jeffersonpimenta/Carga_Eletronica/Readme.md

Projeto de uma carga eletrônica inteligente (electronic load) apresentado como trabalho de fim de curso pela Universidade Federal do Ceará.
