jeffersonpimenta/Carga_Eletronica/TCC_UFC/Desenvolvimento de um emulador dinâmico de carga.pdf

# Desenvolvimento de um emulador dinâmico de carga

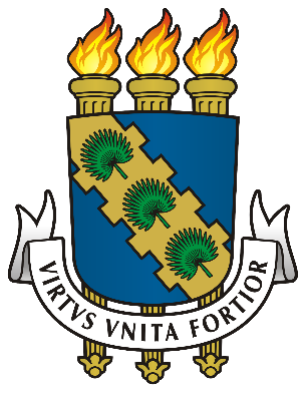
[picture p37: figure]

# JÉFFERSON PIMENTA MELO UNIVERSIDADE FEDERAL DO CEARÁ

# CAMPUS DE SOBRAL

# Emulador dinâmico de carga

# Equipamento eletrônico, de bancada

# Se comporta como uma carga passiva em termos de corrente e potência drenada do equipamento sob ensaio

# Regenerativo e/ou dissipativo

# Configurável em uma gama de valores

# Entrada de corrente CC e/ou CA

# Emula cargas lineares e/ou não lineares

# Emula cargas dinâmicas e estáticas (sazonalidade)

Conceitos básicos

Utilidades

Objetivos

Desenvolvimento

Resultados

Conclusões

Melhorias Futuras

# Fluxo de potência

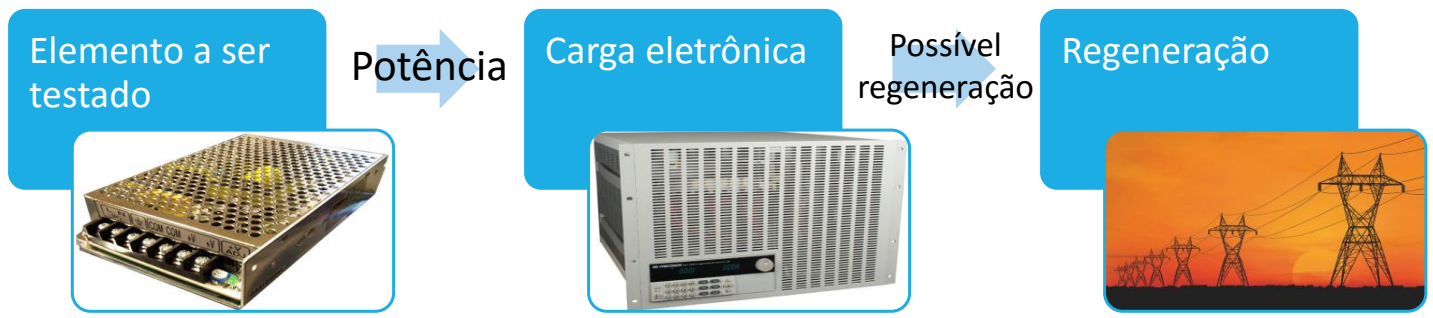
[picture p38: figure]
Elemento a ser testado; regeneração

Carga eletrônica | Regeneração Potência | Possível

Conceitos básicos

Utilidades

Objetivos

Desenvolvimento

Resultados

Conclusões

Melhorias Futuras

# Modo de operação

# Corrente constante

# Resistência constante

# Potência constante

Conceitos básicos

Utilidades

Objetivos

Desenvolvimento

Resultados

Conclusões

Melhorias Futuras

# Modo de operação

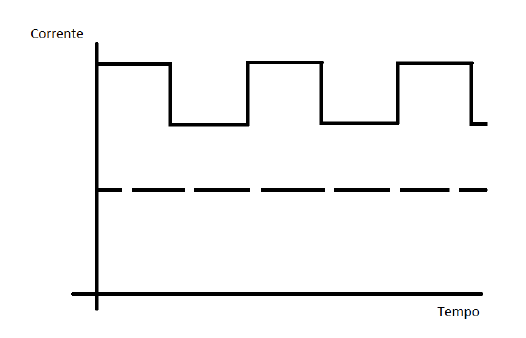
[picture p39: figure]

# Sazonalidade da carga emulada

Conceitos básicos

Utilidades

Objetivos

Desenvolvimento

Resultados

Conclusões

Melhorias Futuras

# Utilidades

Substituem os bancos de resistores, banco de capacitores e banco de indutores em testes de diversos

# equipamentos

- Fontes ininterruptas de energia - Inversores - Gradadores - Fontes de tensão - Fontes de corrente - Chaves eletrônicas ou eletromecânicas - Circuitos de proteção - Fusíveis - Disjuntores - Conectores - Linhas de transmissão - Transformadores - Geradores - Medidores de energia - Conversores chaveados

Conceitos básicos

Utilidades

Objetivos

Desenvolvimento

Resultados

Conclusões

Melhorias Futuras

# Objetivos

# Estudo do funcionamento dos equipamentos disponíveis no mercado

# Desenvolvimento e construção de um equipamento capaz de ensaiar conversores

# - Trabalho em regime de corrente CC - Equipamento deve ser preciso - Interface amigável - Baixo custo - Alta reprodutibilidade

Conceitos básicos

Utilidades

Objetivos

Desenvolvimento

Resultados

Conclusões

Melhorias Futuras

# Desenvolvimento

# Equipamento inspirado no projeto do engenheiro Sueco Lukas Rosén e Sahar Samimi

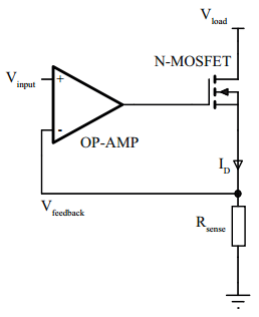
[picture p40: figure]

# Circuito base Fonte: Rosén; Samimi, 2012


# Circuito executado Fonte: autor

Conceitos básicos

Utilidades

Objetivos

Desenvolvimento

Resultados

Conclusões

Melhorias Futuras

# Proteções adotadas


Conceitos básicos

Utilidades

Objetivos

Desenvolvimento

Resultados

Conclusões

Melhorias Futuras

# Medição de corrente


Conceitos básicos

Utilidades

Objetivos

Desenvolvimento

Resultados

Conclusões

Melhorias Futuras

# Medição de tensão

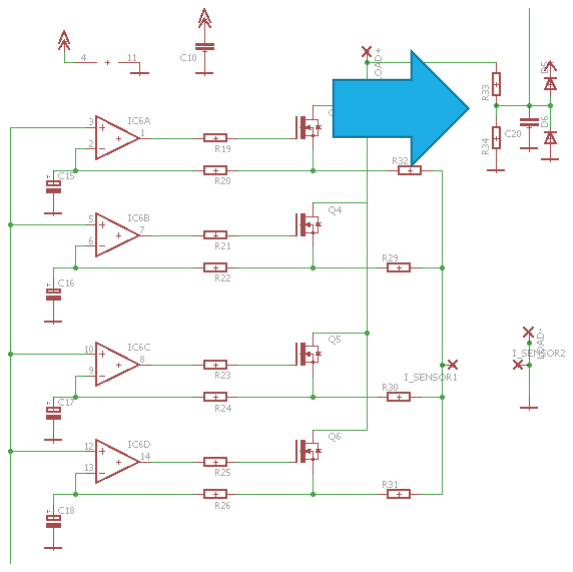
[picture p41: figure]

Conceitos básicos

Utilidades

Objetivos

Desenvolvimento

Resultados

Conclusões

Melhorias Futuras

# Placa de circuito impresso

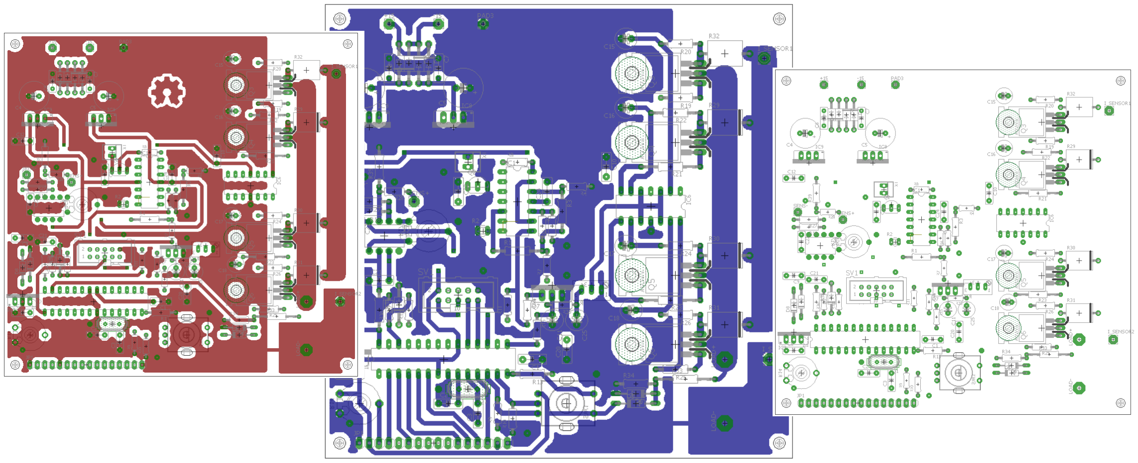
[picture p42: figure]

Conceitos básicos

Utilidades

Objetivos

Desenvolvimento

Resultados

Conclusões

Melhorias Futuras

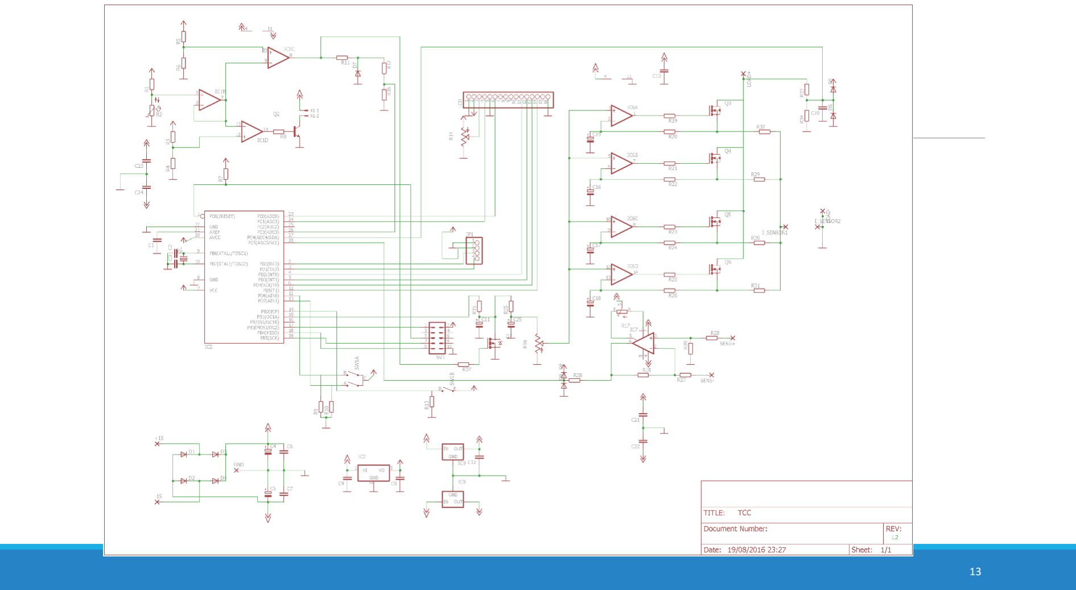
[picture p43: page 13]

# Montagem final

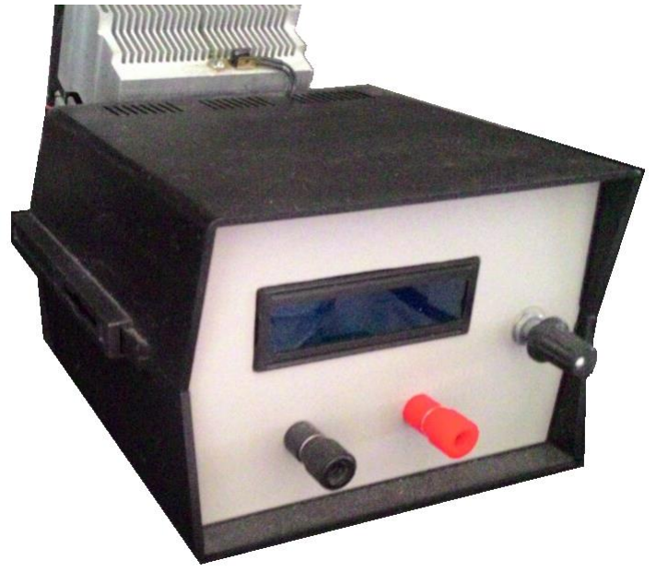
[picture p44: figure]

Conceitos básicos

Utilidades

Objetivos

Desenvolvimento

Resultados

Conclusões

Melhorias Futuras

# Interface

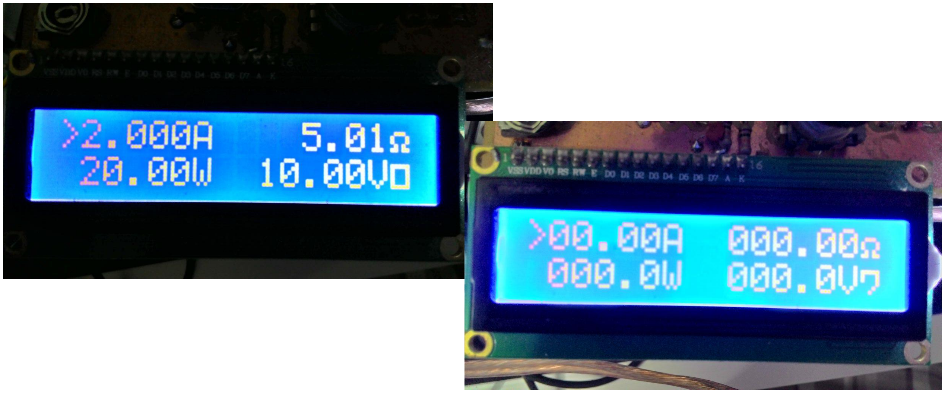
[picture p45: figure]

Conceitos básicos

Utilidades

Objetivos

Desenvolvimento

Resultados

Conclusões

Melhorias Futuras

# PCI

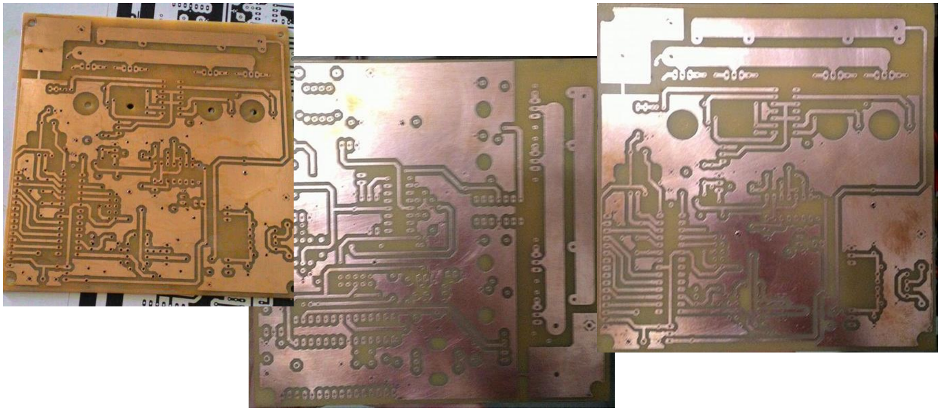
[picture p46: figure]

Conceitos básicos

Utilidades

Objetivos

Desenvolvimento

Resultados

Conclusões

Melhorias Futuras

# Conclusões

# Funcionamento estável

# Pequeno erro no desenho da PCI

# Necessidade de um software para exportar os dados para o computador, bem como seu controle

# Construção fácil, flexível e com componentes comuns no mercado

# Sobreviveu ao “teste de fogo” com os alunos de eletrônica de potência

Conceitos básicos

Utilidades

Objetivos

Desenvolvimento

Resultados

Conclusões

Melhorias Futuras

# Melhorias futuras

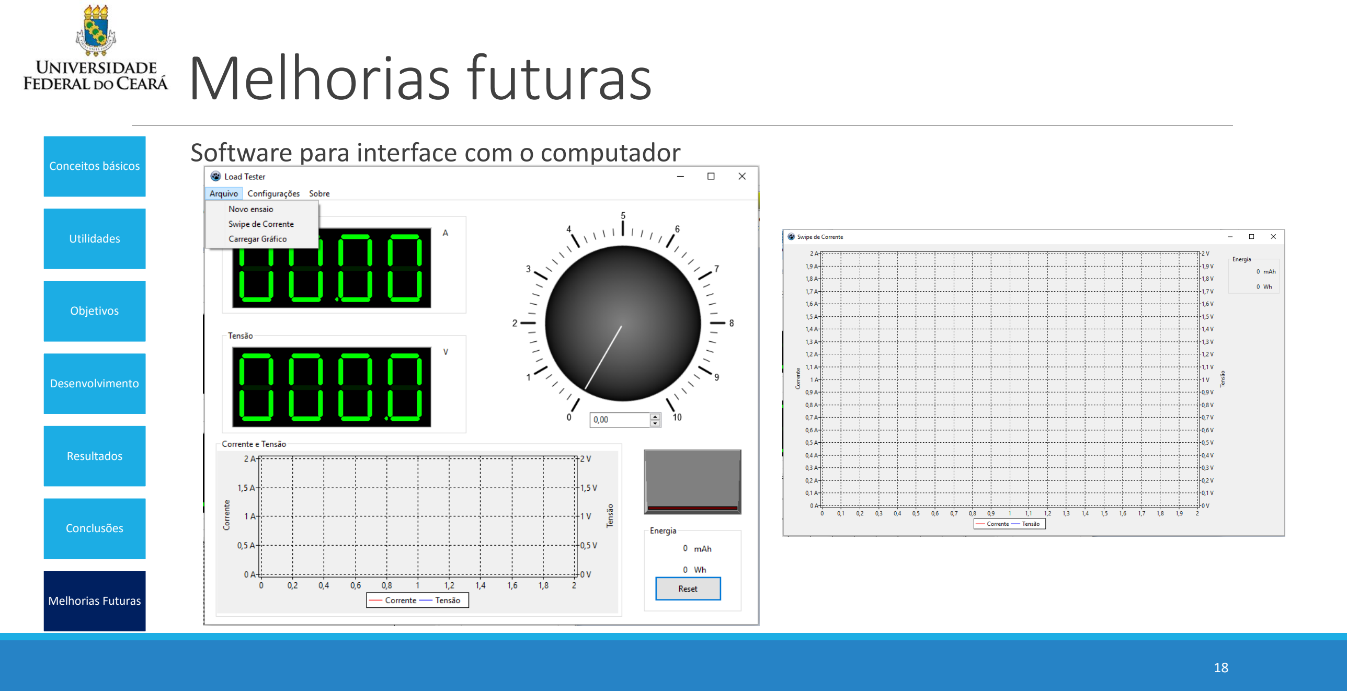
[picture p47: page 18]

# Software para interface com o computador

Conceitos básicos

Utilidades

Objetivos

Desenvolvimento

Resultados

Conclusões

Melhorias Futuras

# Melhorias futuras

# Proteção contra sobretensão na entrada do equipamento

# Utilização de sensores de corrente mais precisos

# Utilização de ADC externos ao microcontrolador para leitura de corrente e tensão

# Utilização de um processador mais poderoso

# Melhorar a malha de controle de corrente

# Dissipadores maiores

# Software para interface com o computador

Conceitos básicos

Utilidades

Objetivos

Desenvolvimento

Resultados

Conclusões

Melhorias Futuras

# JEFFERSON.PIMENTA@HOTMAIL.COM
