jeffersonpimenta/Carga_Eletronica/Fotos/board1.png

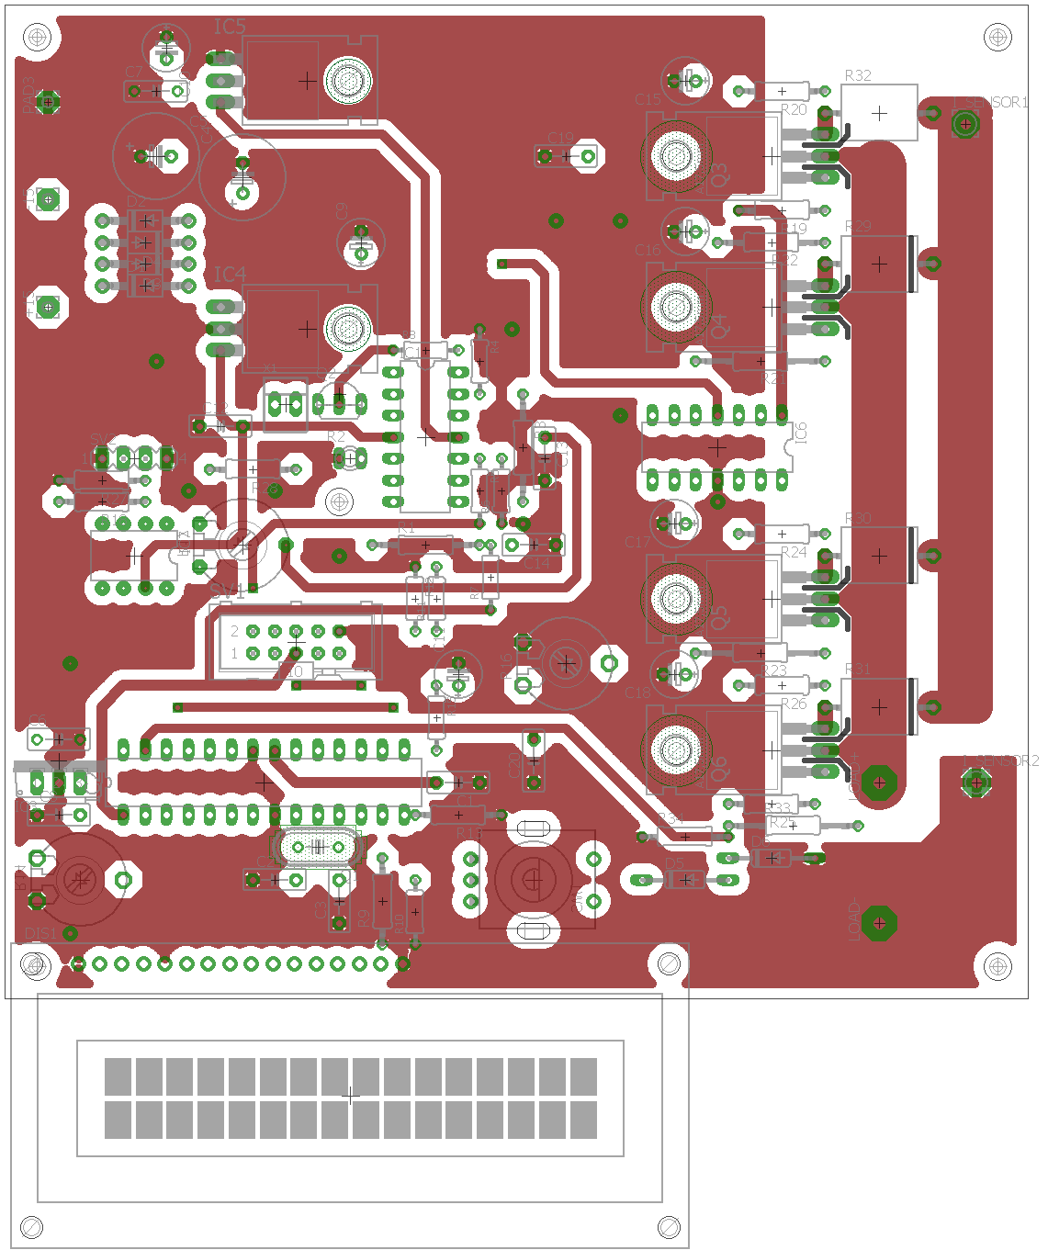
Fotos/board1.png
