jeffersonpimenta/Carga_Eletronica/Fotos/board2.png

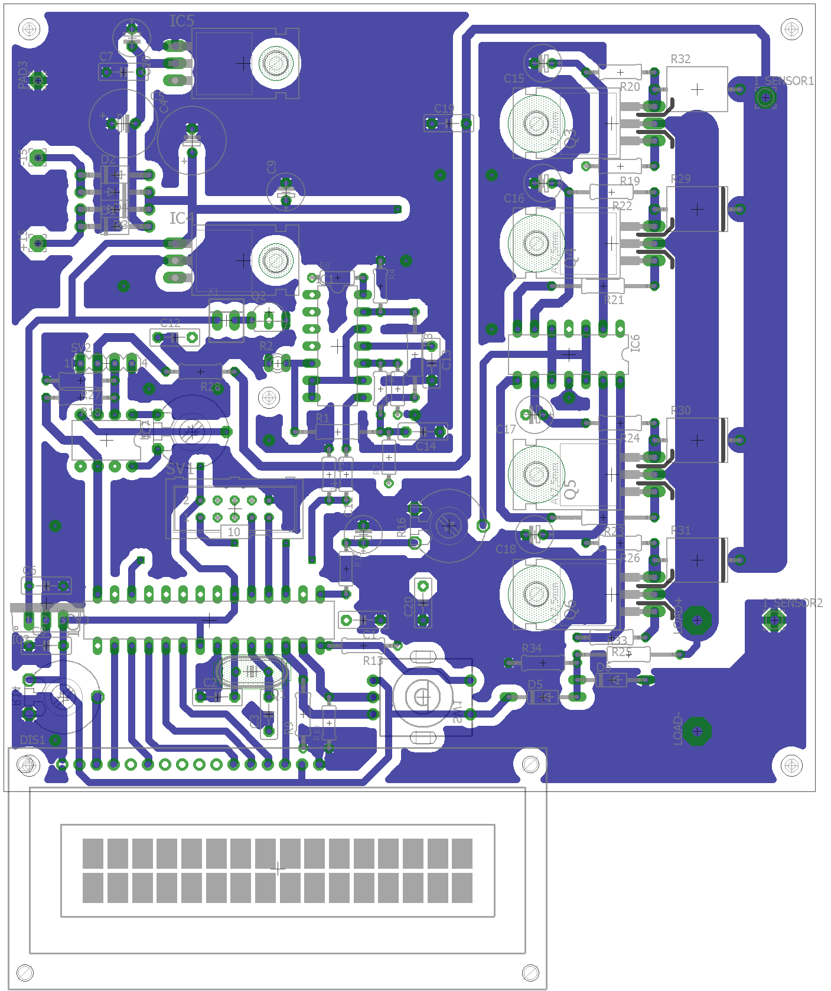
Fotos/board2.png
