jeffersonpimenta/Carga_Eletronica/Fotos/Software1.png

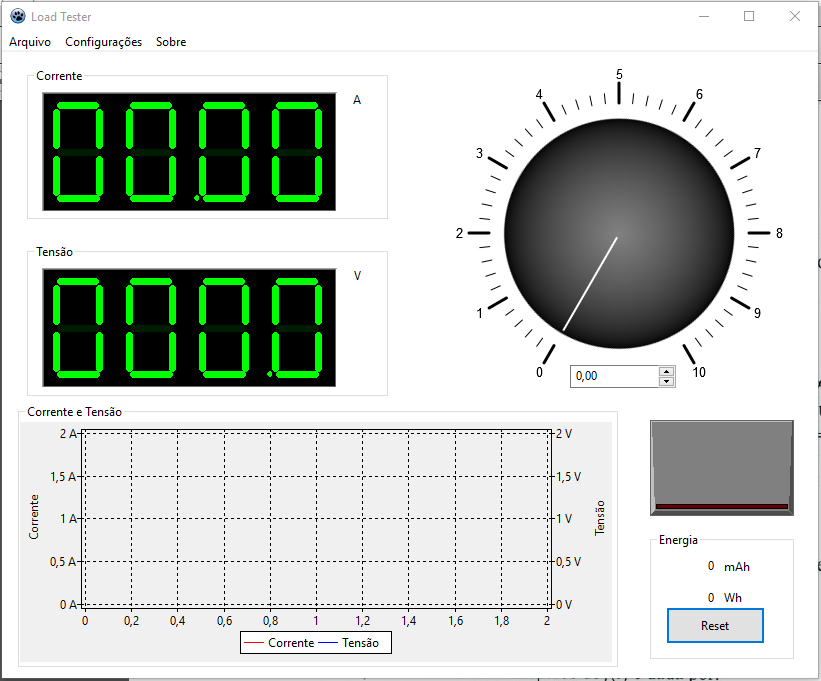
Fotos/Software1.png
