jeffersonpimenta/Carga_Eletronica/Fotos/Software3.png

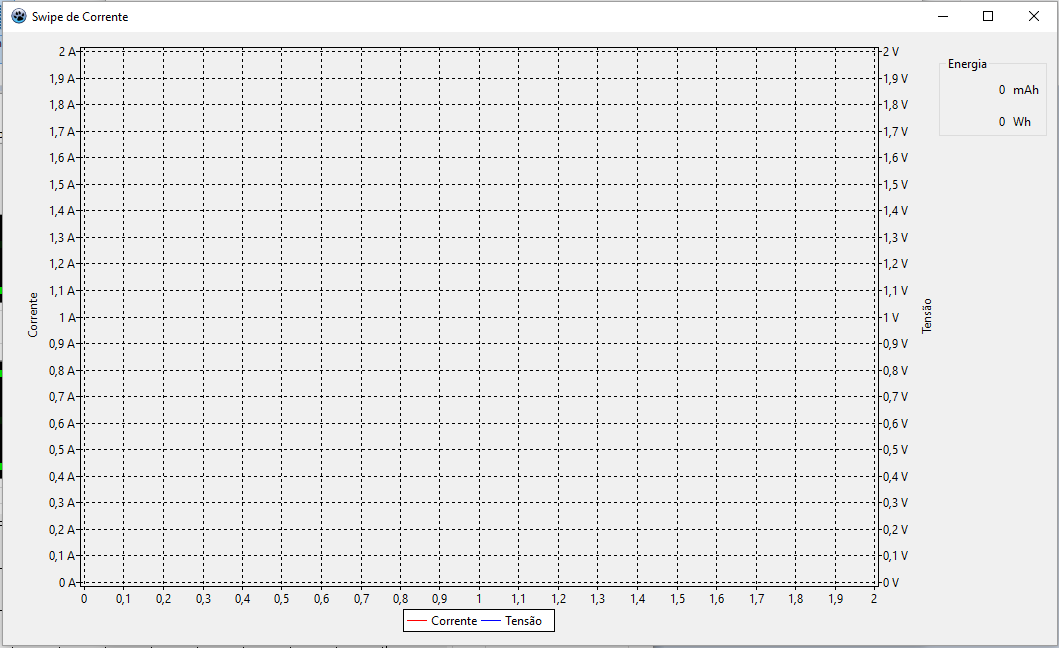
Fotos/Software3.png
