jeffersonpimenta/Carga_Eletronica/Fotos/TCC.png

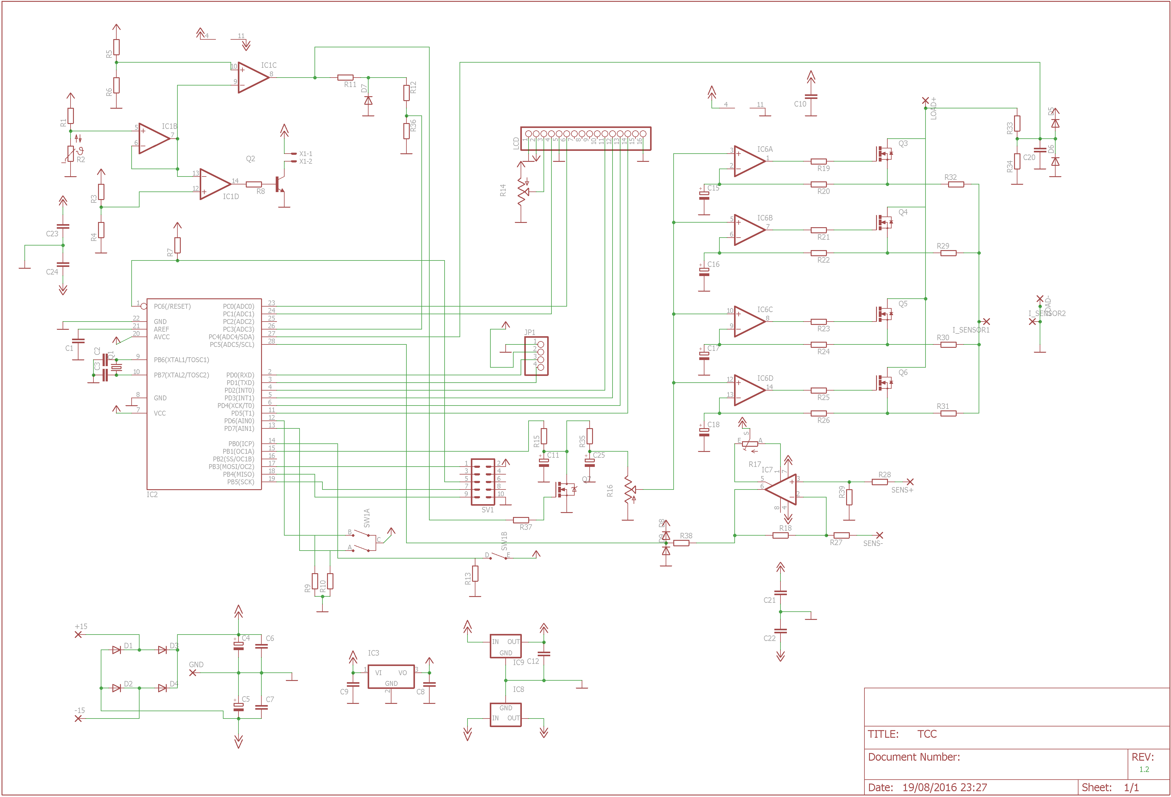
Fotos/TCC.png
