jeffersonpimenta/Carga_Eletronica/Placa/TCC.brd

## EAGLE design Placa/TCC.brd (2017-04-07)

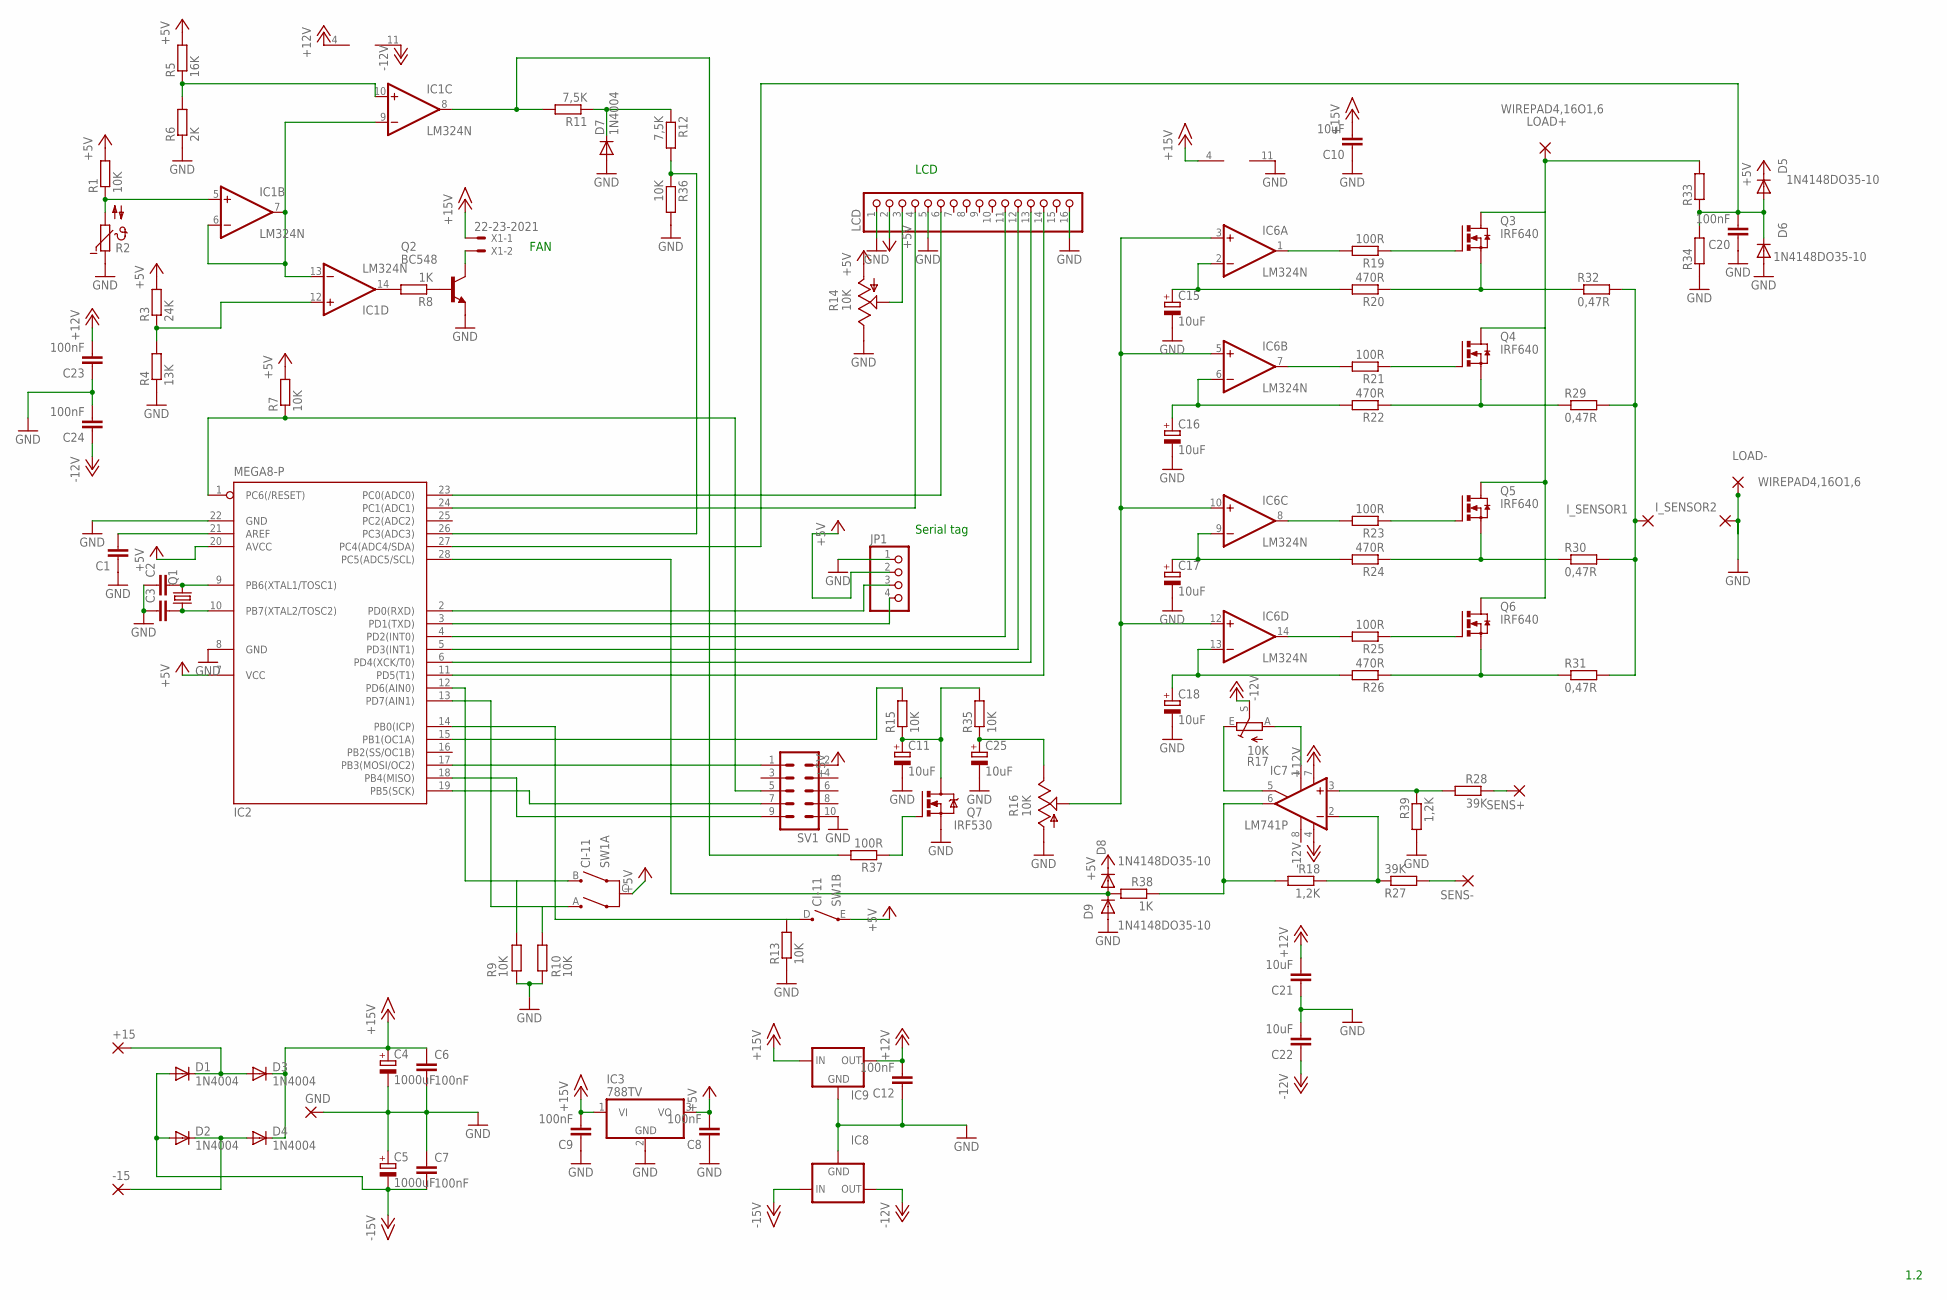
[picture p53: schematic TCC.sch]

Parts:
+15: 2,54/0,9
-15: 2,54/0,9
C1, C2, C3: C5/2.5; C5B2.5
C4, C5: 1000uF; E3,5-10
C6, C7: 100nF; C050-025X075
C8, C9, C12, C20, C23, C24: 100nF; C5B2.5
C10, C21, C22: 10uF; C5B2.5
C11, C15, C16, C17, C18, C25: 10uF; E2,5-6E
D1, D2, D3, D4, D7: 1N4004; DO41-10
D5, D6, D8, D9: 1N4148DO35-10; DO35-10
GND: 2,54/0,9
IC1, IC6: LM324N; DIL14
IC2: MEGA8-P; DIL28-3
IC3: 788TV; TO220V
IC7: LM741P; DIL08
IC8: 79XXS
IC9: 78XXS
I_SENSOR1, I_SENSOR2: 3,17/1,3
JP1: PINHD-1X4; 1X04
LCD: PINHD-1X16; 1X16
LOAD+: WIREPAD4,16O1,6; 4,16O1,6
LOAD-: WIREPAD4,16O1,6; 4,16O1,6
Q1: CRYSTALHC49S; HC49/S
Q2: BC548; TO92-EBC
Q3, Q4, Q5, Q6: IRF640; TO220BH
Q7: IRF530; TO220BV
R1: 10K; 0207/12
R2: NTC640; P640
R3: 24K; 0207/10
R4: 13K; 0204/7
R5: 16K; 0204/7
R6: 2K; 0204/7
R7, R9, R10, R15, R35, R36: 10K; 0204/7
R8: 1K; 0204/7
R11, R12: 7,5K; 0204/7
R13: 10K; 0207/10
R14: 10K; LI10@1
R16: 10K; S64W
R17: 10K; LI10
R18, R39: 1,2K; 0207/10
R19, R25: 100R; 0207/10
R20, R24, R26: 470R; 0207/10
R21, R23: 100R; 0207/15
R22: 470R; 0207/12
R27: 39K; 0207/10
R28: 39K; 0204/7
R29, R30, R31, R32: 0,47R; VTA56
R33: R-EU_0207/15; 0207/15
R34: R-EU_0207/10; 0207/10
R37: 100R; 0204/7
R38: 1K; 0207/10
SENS+: 2,54/1,1
SENS-: 2,54/1,1
SV1: ML10
SW1: CI-11
X1: 22-23-2021

Connections:
+5V: C8.2, D5.C, D8.C, IC2.7 (VCC), IC2.20 (AVCC), IC3.3 (VO), JP1.2, LCD.2, R1.2, R3.2, R5.2, R7.2, R14.A, SV1.2, SW1.C, SW1.E
+12V: C12.2, C21.2, C23.2, IC1.4 (V+), IC7.7 (V+), IC9.OUT
+15V: C4.+, C6.1, C9.2, C10.2, D3.C, D4.C, IC3.1 (VI), IC6.4 (V+), IC9.IN, X1.1
-12V: C22.1, C24.1, IC1.11 (V-), IC7.4 (V-), IC8.OUT, R17.S
-15V: C5.-, C7.2, D1.A, D2.A, IC8.IN
GND: C1.1, C2.1, C3.1, C4.-, C5.+, C6.2, C7.1, C8.1, C9.1, C10.1, C11.-, C12.1, C15.-, C16.-, C17.-, C18.-, C20.1, C21.1, C22.2, C23.1, C24.2, C25.-, D6.A, D7.A, D9.A, GND.1, IC2.8 (GND), IC2.22 (GND), IC3.2 (GND), IC6.11 (V-), IC8.GND, IC9.GND, I_SENSOR2.1, JP1.1, LCD.1, LCD.5, LCD.16, LOAD-.1, Q2.E, Q7.S, R2.1, R4.1, R6.1, R9.1, R10.1, R13.1, R14.E, R16.A, R34.1, R36.2, R39.2, SV1.10
unnamed: C2.2, IC2.9 (PB6(XTAL1/TOSC1)), Q1.2
unnamed: C3.2, IC2.10 (PB7(XTAL2/TOSC2)), Q1.1
unnamed: IC2.17 (PB3(MOSI/OC2)), SV1.1
unnamed: IC2.18 (PB4(MISO)), SV1.9
unnamed: IC2.19 (PB5(SCK)), SV1.7
unnamed: IC2.1 (PC6(/RESET)), R7.1, SV1.5
unnamed: C1.2, IC2.21 (AREF)
unnamed: IC1.8 (OUT), R11.2, R37.2
unnamed: IC2.24 (PC1(ADC1)), LCD.4
unnamed: IC2.23 (PC0(ADC0)), LCD.6
unnamed: IC2.4 (PD2(INT0)), LCD.11
unnamed: IC2.5 (PD3(INT1)), LCD.12
unnamed: IC2.14 (PB0(ICP)), R13.2, SW1.D
unnamed: IC2.11 (PD5(T1)), LCD.14
unnamed: IC2.12 (PD6(AIN0)), R9.2, SW1.B
unnamed: C11.+, Q7.D, R15.1, R35.2
unnamed: Q3.S, R20.1, R32.1
unnamed: Q4.S, R22.1, R29.1
unnamed: Q5.S, R24.1, R30.1
unnamed: IC2.13 (PD7(AIN1)), R10.2, SW1.A
unnamed: Q6.S, R26.1, R31.1
unnamed: IC6.1 (OUT), R19.2
unnamed: Q3.G, R19.1
unnamed: IC6.7 (OUT), R21.2
unnamed: Q4.G, R21.1
unnamed: LOAD+.1, Q3.D, Q4.D, Q5.D, Q6.D, R33.2
unnamed: IC6.3 (+IN), IC6.5 (+IN), IC6.10 (+IN), IC6.12 (+IN), R16.S
unnamed: C15.+, IC6.2 (-IN), R20.2
unnamed: C17.+, IC6.9 (-IN), R24.2
unnamed: C16.+, IC6.6 (-IN), R22.2
unnamed: IC7.2 (-IN), R18.1, R27.1
unnamed: IC1.6 (-IN), IC1.7 (OUT), IC1.9 (-IN), IC1.13 (-IN)
unnamed: C18.+, IC6.13 (-IN), R26.2
unnamed: D8.A, D9.C, IC2.28 (PC5(ADC5/SCL)), R38.2
unnamed: IC7.1 (ON1), R17.A
unnamed: C25.+, R16.E, R35.1
unnamed: IC2.15 (PB1(OC1A)), R15.2
unnamed: IC7.5 (ON2), R17.E
unnamed: C20.2, D5.A, D6.C, IC2.27 (PC4(ADC4/SDA)), R33.1, R34.2
unnamed: LCD.3, R14.S
unnamed: IC1.5 (+IN), R1.1, R2.2
unnamed: IC1.10 (+IN), R5.1, R6.2
unnamed: IC7.3 (+IN), R28.2, R39.1
unnamed: Q2.B, R8.1
unnamed: IC2.26 (PC3(ADC3)), R12.2, R36.1
unnamed: Q2.C, X1.2
unnamed: IC1.14 (OUT), R8.2
unnamed: IC1.12 (+IN), R3.1, R4.2
unnamed: I_SENSOR1.1, R29.2, R30.2, R31.2, R32.2
unnamed: IC2.6 (PD4(XCK/T0)), LCD.13
unnamed: IC6.8 (OUT), R23.2
unnamed: Q5.G, R23.1
unnamed: IC6.14 (OUT), R25.2
unnamed: Q6.G, R25.1
unnamed: Q7.G, R37.1
unnamed: D7.C, R11.1, R12.1
unnamed: +15.1, D1.C, D3.A
unnamed: -15.1, D2.C, D4.A
unnamed: IC7.6 (OUT), R18.2, R38.1
unnamed: R27.2, SENS-.1
unnamed: R28.1, SENS+.1
unnamed: IC2.3 (PD1(TXD)), JP1.4
unnamed: IC2.2 (PD0(RXD)), JP1.3

Notes on the sheet:
1.2
Serial tag
LCD
FAN

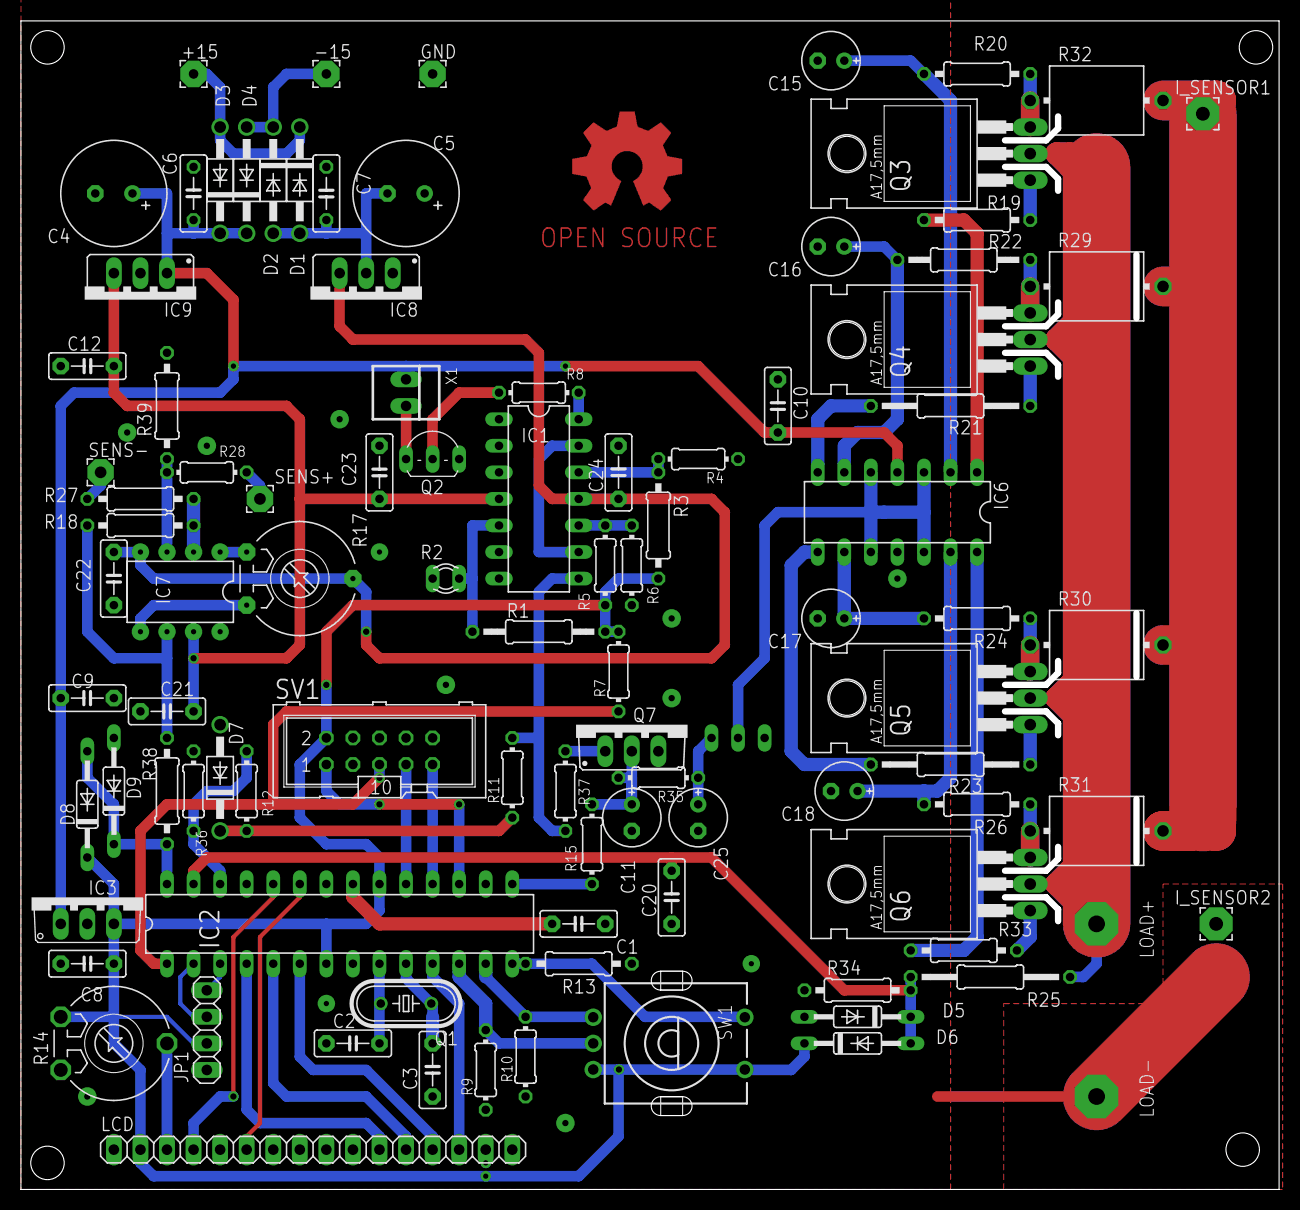
[picture p54: board TCC.brd from above]

Board: 2 copper layers, 120.3 x 111.8 mm, 98 parts (1 on the bottom side), 69 nets.
