jeffersonpimenta/Carga_Eletronica/Código/TCC/lcd.h

/****************************************************************************
  Jéfferson Pimenta
  */

#ifndef F_CPU
#define F_CPU 4000000UL
#endif

#include <avr/io.h>
#include <util/delay.h>

// especifique as portas de conexão do lcd
#define lcd_D7_port     PORTD                   // lcd D7
#define lcd_D7_bit      PORTD5
#define lcd_D7_ddr      DDRD

#define lcd_D6_port     PORTD                   // lcd D6
#define lcd_D6_bit      PORTD4
#define lcd_D6_ddr      DDRD

#define lcd_D5_port     PORTD                   // lcd D5
#define lcd_D5_bit      PORTD3
#define lcd_D5_ddr      DDRD

#define lcd_D4_port     PORTD                   // lcd D4
#define lcd_D4_bit      PORTD2
#define lcd_D4_ddr      DDRD

#define lcd_E_port      PORTC                   // lcd Enable
#define lcd_E_bit       PORTC0
#define lcd_E_ddr       DDRC

#define lcd_RS_port     PORTC                   // lcd RS
#define lcd_RS_bit      PORTC1
#define lcd_RS_ddr      DDRC

// LCD module information
#define lcd_LineOne     0x00                    // start of line 1
#define lcd_LineTwo     0x40                    // start of line 2
//#define   lcd_LineThree   0x14                  // start of line 3 (20x4)
//#define   lcd_lineFour    0x54                  // start of line 4 (20x4)
//#define   lcd_LineThree   0x10                  // start of line 3 (16x4)
//#define   lcd_lineFour    0x50                  // start of line 4 (16x4)

// LCD instructions
#define lcd_Clear           0b00000001          // replace all characters with ASCII 'space'
#define lcd_Home            0b00000010          // return cursor to first position on first line
#define lcd_EntryMode       0b00000110          // shift cursor from left to right on read/write
#define lcd_DisplayOff      0b00001000          // turn display off
#define lcd_DisplayOn       0b00001100          // display on, cursor off, don't blink character
#define lcd_FunctionReset   0b00110000          // reset the LCD
#define lcd_FunctionSet4bit 0b00101000          // 4-bit data, 2-line display, 5 x 7 font
#define lcd_SetCursor       0b10000000          // set cursor position
#define Set_blink_on        0b00001111
#define Set_blink_off       0b00001100


// Function Prototypes





/*============================== 4-bit LCD Functions ======================*/
/*
  Name:     lcd_init
  Purpose:  initialize the LCD module for a 4-bit data interface
  Entry:    equates (LCD instructions) set up for the desired operation
  Exit:     no parameters
  Notes:    uses time delays rather than checking the busy flag
*/
void lcd_init(void)
{
	
	// configure the microprocessor pins for the data lines
	lcd_D7_ddr |= (1<<lcd_D7_bit);                  // 4 data lines - output
	lcd_D6_ddr |= (1<<lcd_D6_bit);
	lcd_D5_ddr |= (1<<lcd_D5_bit);
	lcd_D4_ddr |= (1<<lcd_D4_bit);

	// configure the microprocessor pins for the control lines
	lcd_E_ddr |= (1<<lcd_E_bit);                    // E line - output
	lcd_RS_ddr |= (1<<lcd_RS_bit);                  // RS line - output
	
	
// Power-up delay
    _delay_ms(100);                                 // initial 40 mSec delay

// IMPORTANT - At this point the LCD module is in the 8-bit mode and it is expecting to receive  
//   8 bits of data, one bit on each of its 8 data lines, each time the 'E' line is pulsed.
//
// Since the LCD module is wired for the 4-bit mode, only the upper four data lines are connected to 
//   the microprocessor and the lower four data lines are typically left open.  Therefore, when 
//   the 'E' line is pulsed, the LCD controller will read whatever data has been set up on the upper 
//   four data lines and the lower four data lines will be high (due to internal pull-up circuitry).
//
// Fortunately the 'FunctionReset' instruction does not care about what is on the lower four bits so  
//   this instruction can be sent on just the four available data lines and it will be interpreted 
//   properly by the LCD controller.  The 'lcd_write_4' subroutine will accomplish this if the 
//   control lines have previously been configured properly.

// Set up the RS and E lines for the 'lcd_write_4' subroutine.
    lcd_RS_port &= ~(1<<lcd_RS_bit);                // select the Instruction Register (RS low)
    lcd_E_port &= ~(1<<lcd_E_bit);                  // make sure E is initially low

// Reset the LCD controller
    lcd_write_4(lcd_FunctionReset);                 // first part of reset sequence
    _delay_ms(10);                                  // 4.1 mS delay (min)

    lcd_write_4(lcd_FunctionReset);                 // second part of reset sequence
    _delay_us(200);                                 // 100uS delay (min)

    lcd_write_4(lcd_FunctionReset);                 // third part of reset sequence
    _delay_us(200);                                 // this delay is omitted in the data sheet

// Preliminary Function Set instruction - used only to set the 4-bit mode.
// The number of lines or the font cannot be set at this time since the controller is still in the
//  8-bit mode, but the data transfer mode can be changed since this parameter is determined by one 
//  of the upper four bits of the instruction.
 
    lcd_write_4(lcd_FunctionSet4bit);               // set 4-bit mode
    _delay_us(80);                                  // 40uS delay (min)

// Function Set instruction
    lcd_write_instruction(lcd_FunctionSet4bit);   // set mode, lines, and font
    _delay_us(80);                                  // 40uS delay (min)

// The next three instructions are specified in the data sheet as part of the initialization routine, 
//  so it is a good idea (but probably not necessary) to do them just as specified and then redo them 
//  later if the application requires a different configuration.

// Display On/Off Control instruction
    lcd_write_instruction(lcd_DisplayOff);        // turn display OFF
    _delay_us(80);                                  // 40uS delay (min)

// Clear Display instruction
    lcd_write_instruction(lcd_Clear);             // clear display RAM
    _delay_ms(4);                                   // 1.64 mS delay (min)

// ; Entry Mode Set instruction
    lcd_write_instruction(lcd_EntryMode);         // set desired shift characteristics
    _delay_us(80);                                  // 40uS delay (min)

// This is the end of the LCD controller initialization as specified in the data sheet, but the display
//  has been left in the OFF condition.  This is a good time to turn the display back ON.
 
// Display On/Off Control instruction
    lcd_write_instruction(lcd_DisplayOn);         // turn the display ON
    _delay_us(80);                                  // 40uS delay (min)
}

/*...........................................................................
  Name:     lcd_write_string
; Purpose:  display a string of characters on the LCD
  Entry:    (theString) is the string to be displayed
  Exit:     no parameters
  Notes:    uses time delays rather than checking the busy flag
*/
void lcd_write_string(uint8_t theString[])
{
    volatile int i = 0;                             // character counter*/
    while (theString[i] != 0)
    {
        lcd_write_character(theString[i]);
        i++;
        _delay_us(80);                              // 40 uS delay (min)
    }
}

/*...........................................................................
  Name:     lcd_write_character
  Purpose:  send a byte of information to the LCD data register
  Entry:    (theData) is the information to be sent to the data register
  Exit:     no parameters
  Notes:    does not deal with RW (busy flag is not implemented)
*/

void lcd_write_character(uint8_t theData)
{
    lcd_RS_port |= (1<<lcd_RS_bit);                 // select the Data Register (RS high)
    lcd_E_port &= ~(1<<lcd_E_bit);                  // make sure E is initially low
    lcd_write_4(theData);                           // write the upper 4-bits of the data
    lcd_write_4(theData << 4);                      // write the lower 4-bits of the data
}

/*...........................................................................
  Name:     lcd_write_instruction
  Purpose:  send a byte of information to the LCD instruction register
  Entry:    (theInstruction) is the information to be sent to the instruction register
  Exit:     no parameters
  Notes:    does not deal with RW (busy flag is not implemented)
*/
void lcd_write_instruction(uint8_t theInstruction)
{
    lcd_RS_port &= ~(1<<lcd_RS_bit);                // select the Instruction Register (RS low)
    lcd_E_port &= ~(1<<lcd_E_bit);                  // make sure E is initially low
    lcd_write_4(theInstruction);                    // write the upper 4-bits of the data
    lcd_write_4(theInstruction << 4);               // write the lower 4-bits of the data
	
}


/*...........................................................................
  Name:     lcd_write_4
  Purpose:  send a byte of information to the LCD module
  Entry:    (theByte) is the information to be sent to the desired LCD register
            RS is configured for the desired LCD register
            E is low
            RW is low
  Exit:     no parameters
  Notes:    use either time delays or the busy flag
*/
void lcd_write_4(uint8_t theByte)
{
    lcd_D7_port &= ~(1<<lcd_D7_bit);                        // assume that data is '0'
    if (theByte & 1<<7) lcd_D7_port |= (1<<lcd_D7_bit);     // make data = '1' if necessary

    lcd_D6_port &= ~(1<<lcd_D6_bit);                        // repeat for each data bit
    if (theByte & 1<<6) lcd_D6_port |= (1<<lcd_D6_bit);

    lcd_D5_port &= ~(1<<lcd_D5_bit);
    if (theByte & 1<<5) lcd_D5_port |= (1<<lcd_D5_bit);

    lcd_D4_port &= ~(1<<lcd_D4_bit);
    if (theByte & 1<<4) lcd_D4_port |= (1<<lcd_D4_bit);

// write the data
                                                    // 'Address set-up time' (40 nS)
    lcd_E_port |= (1<<lcd_E_bit);                   // Enable pin high
    _delay_us(1);                                   // implement 'Data set-up time' (80 nS) and 'Enable pulse width' (230 nS)
    lcd_E_port &= ~(1<<lcd_E_bit);                  // Enable pin low
    _delay_us(1);                                   // implement 'Data hold time' (10 nS) and 'Enable cycle time' (500 nS)
	
	_delay_ms(5);
}


void lcd_write_int(uint8_t a){
	char str[10];
	itoa(a, str, 10);
	lcd_write_string(str);
};

void lcd_set_position(uint8_t x,uint8_t y){
	y=y-1;
	x=x+64*y;
	x|= 0b10000000;
	lcd_write_instruction(x);
};

lcd_write_xy(uint8_t msg, uint8_t x,uint8_t y){
	lcd_set_position(x,y);
	lcd_write_string(msg);
}

void lcd_write_int16(double a,uint8_t tam,uint8_t prec){
	uint8_t str[10];
	dtostrf(a,tam,prec,str);

	lcd_write_string(str);
};
